Kishor5115/SkyForge-RISCV-SoC/docs/WAIVED_CHECKS.md

# SkyForge SoC — Signoff Waived Checks

Records all DRC/timing checks formally waived in the SkyForge v1.0 signoff
(`RUN_4_GDS_SIGNOFF`). All other checks are fully clean with zero violations.

## Final Signoff Metrics (RUN_4_GDS_SIGNOFF)

| Check | Result |
|---|---|
| `klayout__drc_error__count` | **0** |
| `design__lvs_error__count` | **0** |
| `design__lvs_device_difference__count` | **0** |
| `design__lvs_net_difference__count` | **0** |
| `route__drc_errors` | **0** |
| LVS verdict | **"Circuits match uniquely."** |
| STA (setup/hold @ 100 MHz TT) | WNS ≥ 0, TNS = 0, 0 hold violations |
| Antenna | 0 violations |

> **LVS is fully clean — not a waiver.** Netgen reports "Circuits match uniquely" with
> zero device/net/pin differences. There is exactly **one** formal waiver, described
> below (the OpenRAM SRAM internal DRC), which is standard hard-macro practice.

---

## Formal Waivers

### Waiver 1: OpenRAM SRAM Internal DRC (KLayout `sky130A` mr.drc)

**Scope:** Internal violations inside the pre-characterized OpenRAM SRAM macro GDS only.
All SoC routing, standard-cell fabric, and the macro integration boundary are fully
checked with **0 violations**.

**History:**
- Full-GDS KLayout run (initial): **2067 violations** — all `nsdm`/`nwell`/`psdm`
  (well/implant) rules inside the OpenRAM bitcell array.
- After `sky130A_mr_sram_waived.drc` (well/implant cell-scoped exclusion): **3 residual** —
  2× `m1.2` (met1 spacing) + 1× `m2.2` (met2 spacing) inside the
  `sky130_replica_bitcell_array` and `wmask_dff` subcells. Confirmed by running the same
  deck on the **standalone SRAM GDS** — identical 3 edge-pairs reproduced, proving these
  are inside the OpenRAM compiler output (≈10 nm spacing shorts: 0.13 vs 0.14 µm min),
  not in SoC routing or the integration boundary.
- After extending the `not_sram` cell scope to cover the `m1.2`/`m2.2` **spacing** rules
  (width rules still checked on the full layer): **0.**

**Engineering justification:**
Industry-standard hard-macro DRC practice. The SRAM is an unmodified OpenRAM compiler
output. Its internal violations are in the compiler-generated bitcell array, not in SoC
routing or the integration boundary. The macro is verified standalone; chip-level DRC
verifies only the integration boundary (placement, halo, routing to macro pins) — per
the OpenLane/LibreLane hardening guidance ("GDS DRC on macros, LEF/DEF DRC at the chip
level").

**Waiver implementation:** `librelane/sky130A_mr_sram_waived.drc` — a cell-scoped
exclusion (`SRAM_EXCLUDE` / `not_sram`) applied to `*sky130_sram_*kbyte_*` cells for the
well/implant rules **and** the `m1.2`/`m2.2` metal-spacing rules. Every rule still runs
on all non-SRAM geometry, including all SoC routing.

---

## Informational Notes (Not Waivers)

These are pre-signoff warnings from intermediate steps; none is a blocking signoff
failure, and each is resolved or benign in the final signed-off result.

### Note 1: OpenROAD PSM Power-Grid Violations (global routing)

**Observed:** `Grid check for vccd1 failed: PSM-0069`, 833 violations during global
routing (an *intermediate* step). **Status:** Informational — final Magic DRC = 0,
KLayout DRC = 0, LVS = 0.
**Justification:** PSM (power/IR integrity) requires `VSRC_LOC_FILES` (pad-ring source
locations) for accurate analysis; without a padframe it is pessimistic. Estimated IR
drop < 40 mV (< 2.8 % Vdd), within budget. Accurate PSM/IR signoff is a chip-integration
(padframe) step beyond this padless macro-level implementation.

### Note 2: Antenna Info Missing on `picorv32_axi` Macro Pins

**Observed:** `Cell 'picorv32_axi' has (1) input pin(s) without antenna gate
information` (plus 47 output pins without diffusion info). **Status:** Informational —
final antenna DRC = **0 violations**.
**Justification:** The hardened macro LEF lacks per-pin `ANTENNADIFFAREA`/
`ANTENNAGATEAREA` metadata (a LibreLane hierarchical-flow limitation). OpenROAD resolves
all antenna violations conservatively via diode insertion during detailed routing;
`route__drc_errors = 0`. Confirmed in `RUN_4_GDS_SIGNOFF`.

---

## Reference

- `librelane/sky130A_mr_sram_waived.drc` — the cell-scoped KLayout waiver deck.
- `librelane/docker_asic_flow.py` — the flow that produces `RUN_4_GDS_SIGNOFF`.
