Kishor5115/SkyForge-RISCV-SoC/tb/soc_top_tb.sv

`timescale 1ns / 1ps

module soc_top_tb;

    // -------------------------------------------------------------------------
    // Parameters & Signals
    // -------------------------------------------------------------------------
    parameter MEM_INIT_FILE = "sim/integration_test.hex";
    
    logic        clk;
    logic        rst_n;

    // UART
    logic        uart_tx;
    logic        uart_rx;

    // GPIO
    logic [31:0] gpio_in;
    logic [31:0] gpio_out;
    logic [31:0] gpio_oe;

    // SPI Master
    logic        spi_sclk;
    logic        spi_mosi;
    logic        spi_miso;
    logic [3:0]  spi_cs_n;

    // Flash QSPI
    logic        flash_sclk;
    logic        flash_cs_n;
    logic        flash_mosi;
    logic        flash_miso;

    // JTAG
    logic        jtag_tck;
    logic        jtag_tms;
    logic        jtag_tdi;
    logic        jtag_tdo;

    // Status
    logic        trap;

    // Testbench Control
    logic        start_jtag_test = 0;
    logic [31:0] idcode_val;
    logic [8*19-1:0] output_window = '0;
    logic        seen_uart_apb = 0;

    // -------------------------------------------------------------------------
    // Early diagnostics (no waveform needed)
    // -------------------------------------------------------------------------
    initial begin
        // Wait for reset to be released
        wait(rst_n == 1'b1);
        // Give the reset synchronizer a little time
        #200;

        // If firmware still hasn't touched UART, print some state to debug
        if (!seen_uart_apb) begin
            $display("[TB][DIAG] No UART APB traffic shortly after reset.");
            $display("[TB][DIAG] CPU dbg_pc = 0x%08X", dut.u_soc_core.dbg_cpu_pc);
            $display("[TB][DIAG] BootROM[0] = 0x%08X", dut.u_soc_core.u_bootrom.rom[0]);
        end
    end

    // -------------------------------------------------------------------------
    // Clock & Reset
    // -------------------------------------------------------------------------
    initial begin
        clk = 0;
        forever #5 clk = ~clk; // 100MHz clock
    end

    initial begin
        rst_n = 0;
        #50 rst_n = 1;
    end

    // -------------------------------------------------------------------------
    // SoC Instantiation
    // -------------------------------------------------------------------------
    soc_top #(
        .MEM_INIT_FILE(MEM_INIT_FILE),
        .BOOTROM_ADDR_WIDTH(13),
        .PROGADDR_IRQ(32'h00000010) // Run IRQ from BootROM for integration test
    ) dut (
        .clk        (clk),
        .rst_n      (rst_n),
        .uart_tx    (uart_tx),
        .uart_rx    (uart_rx),
        .gpio_in    (gpio_in),
        .gpio_out   (gpio_out),
        .gpio_oe    (gpio_oe),
        .spi_sclk   (spi_sclk),
        .spi_mosi   (spi_mosi),
        .spi_miso   (spi_miso),
        .spi_cs_n   (spi_cs_n),
        .flash_sclk (flash_sclk),
        .flash_cs_n (flash_cs_n),
        .flash_mosi (flash_mosi),
        .flash_miso (flash_miso),
        .jtag_tck   (jtag_tck),
        .jtag_tms   (jtag_tms),
        .jtag_tdi   (jtag_tdi),
        .jtag_tdo   (jtag_tdo),
        .trap       (trap)
    );

    // -------------------------------------------------------------------------
    // Hardware Loopbacks
    // -------------------------------------------------------------------------
    // GPIO Loopback
    assign gpio_in = gpio_out;

    // SPI Loopback
    assign spi_miso = spi_mosi;

    // Flash Loopback (Dummy response, just to keep it from hanging if it tries to read)
    assign flash_miso = 1'b1;

    // UART Loopback (Not used, we just monitor TX)
    assign uart_rx = 1'b1;

    // Removed buggy behavioral UART receiver. We print directly from APB writes below.

    // To make it 100% reliable, we peek at the UART TX register writes
    // internal to the DUT.
    always @(posedge clk) begin
        // One-time visibility: did firmware ever touch the UART?
        if (!seen_uart_apb && dut.u_soc_core.psel_uart && dut.u_soc_core.penable_uart) begin
            seen_uart_apb <= 1'b1;
            if (dut.u_soc_core.pwrite_uart) begin
                $display("[TB] First UART APB WRITE addr=0x%08X data=0x%08X", dut.u_soc_core.paddr_uart, dut.u_soc_core.pwdata_uart);
            end else begin
                $display("[TB] First UART APB READ  addr=0x%08X", dut.u_soc_core.paddr_uart);
            end
        end

        if (dut.u_soc_core.psel_uart && dut.u_soc_core.penable_uart && dut.u_soc_core.pwrite_uart) begin
            if (dut.u_soc_core.paddr_uart[7:0] == 8'h00) begin // UART_TX_DATA
                $write("%c", dut.u_soc_core.pwdata_uart[7:0]);
                $fflush();
                output_window = {output_window[8*18-1:0], dut.u_soc_core.pwdata_uart[7:0]};
                
                if (output_window[8*19-1:0] == "---FIRMWARE_PASS---") begin
                    $display("\n[TB] Detected FIRMWARE_PASS. Starting JTAG Test...");
                    start_jtag_test = 1;
                end
                if (output_window[8*15-1:0] == "---TEST_FAIL---") begin
                    $display("\n[TB] Detected TEST_FAIL from firmware.");
                    $fatal(1, "Integration Test Failed.");
                end
            end
        end
    end

    // If the CPU traps, fail fast (helps catch bad ROM images / bad mappings)
    always @(posedge clk) begin
        if (trap) begin
            $fatal(1, "[TB] CPU trap asserted.");
        end
    end

    // -------------------------------------------------------------------------
    // JTAG Master / Self-Test Sequence
    // -------------------------------------------------------------------------

    task jtag_reset;
        begin
            jtag_tck = 0; jtag_tms = 1; jtag_tdi = 0;
            // 5 clocks with TMS=1 ensures Test-Logic-Reset
            repeat(5) begin
                #50 jtag_tck = 1;
                #50 jtag_tck = 0;
            end
        end
    endtask

    task jtag_shift_ir(input logic [3:0] ir_val);
        begin
            // Move to Shift-IR
            // From TLR: 0(Run-Test-Idle) -> 1(Sel-DR) -> 1(Sel-IR) -> 0(Capture-IR) -> 0(Shift-IR)
            jtag_tms=0; #50 jtag_tck=1; #50 jtag_tck=0; // RTI
            jtag_tms=1; #50 jtag_tck=1; #50 jtag_tck=0; // Sel-DR
            jtag_tms=1; #50 jtag_tck=1; #50 jtag_tck=0; // Sel-IR
            jtag_tms=0; #50 jtag_tck=1; #50 jtag_tck=0; // Cap-IR
            jtag_tms=0; #50 jtag_tck=1; #50 jtag_tck=0; // Shift-IR
            
            // Shift 4 bits
            for(int i=0; i<4; i++) begin
                jtag_tdi = ir_val[i];
                if (i == 3) jtag_tms = 1; // Exit-1-IR on last bit
                else jtag_tms = 0;
                #50 jtag_tck=1; #50 jtag_tck=0;
            end
            
            // Update-IR -> Run-Test-Idle
            jtag_tms=1; #50 jtag_tck=1; #50 jtag_tck=0; // Update-IR
            jtag_tms=0; #50 jtag_tck=1; #50 jtag_tck=0; // RTI
        end
    endtask

    task jtag_shift_dr_32(input logic [31:0] dr_in, output logic [31:0] dr_out);
        begin
            // Move to Shift-DR
            // From RTI: 1(Sel-DR) -> 0(Cap-DR) -> 0(Shift-DR)
            jtag_tms=1; #50 jtag_tck=1; #50 jtag_tck=0; // Sel-DR
            jtag_tms=0; #50 jtag_tck=1; #50 jtag_tck=0; // Cap-DR
            jtag_tms=0; #50 jtag_tck=1; #50 jtag_tck=0; // Shift-DR
            
            dr_out = 0;
            for(int i=0; i<32; i++) begin
                jtag_tdi = dr_in[i];
                if (i == 31) jtag_tms = 1; // Exit-1-DR on last bit
                else jtag_tms = 0;
                
                #25;
                dr_out[i] = jtag_tdo; // Sample TDO before posedge
                #25 jtag_tck=1; #50 jtag_tck=0;
            end
            
            // Update-DR -> Run-Test-Idle
            jtag_tms=1; #50 jtag_tck=1; #50 jtag_tck=0; // Update-DR
            jtag_tms=0; #50 jtag_tck=1; #50 jtag_tck=0; // RTI
        end
    endtask

    initial begin
        jtag_tck = 0;
        jtag_tms = 1;
        jtag_tdi = 0;
        
        wait(start_jtag_test == 1);
        
        $display("[TB] Performing JTAG Test...");
        jtag_reset();
        
        // 1. Read IDCODE (IR = 0x1)
        jtag_shift_ir(4'h1);
        
        jtag_shift_dr_32(32'h0, idcode_val);
        $display("[TB] Read JTAG IDCODE: 0x%08X", idcode_val);
        if (idcode_val != 32'h10005001) begin
            $fatal(1, "JTAG IDCODE mismatch!");
        end
        
        $display("[TB] ---TEST_PASS---");
        $finish;
    end

    // -------------------------------------------------------------------------
    // Timeout
    // -------------------------------------------------------------------------
    initial begin
        #50000000; // 50ms timeout
        $display("\n[TB] Simulation Timeout!");
        $fatal(1, "Integration Test Failed.");
    end

endmodule
