Kishor5115/SkyForge-RISCV-SoC/(commit log)

2026-04-27 feat: UART added
2026-04-27 feat: timer and gpio added
2026-04-29 feat: SPI added along with firmware support
2026-05-03 feat: implement SoC infrastructure with new drivers, boot ROM, JTAG debug, and testbench suite
2026-05-30 feat: integrate FreeRTOS kernel, update SoC RTL, and refactor debug module logic
    [gdb_init.cfg]
2026-05-30 fix in the testbench and debug module
    [macro.cfg, pin_order.cfg]
2026-06-04 fix(asic): resolve SRAM STA blackbox, LVS, IR drop, and add implementation report
    - openram/build/*.lib: full timing arcs (clk→Q 2.6ns, setup 0.5ns, hold 0.25ns)
    from published sky130 SRAM characterization — unblocks STA
    - openram/generate_stub_gds.py: gdspy script to generate stub GDS in <10min,
    avoiding 4-8h full OpenRAM compile — unblocks LVS
    - openlane/config.json: add LVS_IGNORE_CELLS for SRAM, remove missing GDS ref,
    fix FP_CORE_UTIL to 45%, add MAGIC_EXT_USE_GDS flag
    - constraints/soc_core.sdc: add SRAM port delays, false paths, clock uncertainty,
    set_driving_cell/set_load, max_transition/fanout
    - flow/scripts/analyze_ir_drop.tcl: OpenROAD analyze_power_grid script for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
2026-06-09 feat(firmware): interactive FreeRTOS+CLI shell over UART
    Add an interactive command-line shell to the firmware using FreeRTOS+CLI,
    served over the SoC UART. Commands: help, ver, status, memread <addr>,
    gpio <hex>. The vTaskA/vTaskB blinkers keep running concurrently with the
    shell, demonstrating preemptive multitasking alongside interactive I/O.
    Firmware
    - cli/: FreeRTOS_CLI.c/.h (upstream, MIT) + cli_task.c + cli.h
    - main.c: uart_init(14) + cli_start() before the scheduler
    - FreeRTOSConfig.h: configCOMMAND_INT_MAX_OUTPUT_SIZE=256; heap 6KB->12KB
    - Makefile: build/include the CLI sources
    Memory
    - Scale SRAM 16KB -> 32KB (linker, sram_axi.sv, soc_core.sv, interconnect
    decode) to host the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
2026-06-09 fix the bug of keyboard polling
    [main.cpp]
2026-06-13 Update SRAM floorplan to 8 banks (32KB) in sky130 multi-macro flow
2026-06-13 Fix LibreLane v3 schema errors in soc_core_top.yaml
    [soc_core_top.yaml]
2026-06-13 Fix PicoRV32 parameter passing for hard macro compilation
    [picorv32_axi.sv, soc_core.sv]
2026-06-13 Lower placement density to fix DRT pin access failures
2026-06-13 Fix DRT-0073: use li1 as min routing layer for sky130 cell pin access
2026-06-15 Fix and suppress Verilator lint warnings for clean flow
    - picorv32.sv: add lint_off BLKSEQ, UNUSEDSIGNAL, GENUNNAMED, TIMESCALEMOD
    - Name all 7 anonymous generate blocks (gen_fast_mul, gen_mul, gen_no_mul,
    gen_div, gen_no_div, gen_two_cycle_alu, gen_comb_alu) — fixes GENUNNAMED
    - picorv32_pcpi.sv: add lint_off WIDTHEXPAND, WIDTHTRUNC, UNUSEDSIGNAL, CASEINCOMPLETE
    - Add default: ; to MUL and DIV case statements — fixes CASEINCOMPLETE
    - picorv32_axi.sv: add lint_off UNUSEDSIGNAL
    Zero logic changes; all RTL behaviour is 100% identical.
    [picorv32.sv, picorv32_axi.sv, picorv32_pcpi.sv]
2026-06-15 Fix DRT-0073, STA-0441; expand SRAM to 8 banks (32 KB)
    picorv32_core.yaml (rewritten from canonical picorv32a reference):
    - ROOT CAUSE: CTS_APPLY_NDR=half applied 2X clock-net spacing that
    blocked detailed router access to clkbuf A-pins → DRT-0073
    - FIX: CTS_APPLY_NDR: none (verified: 0 DRT-0073, clean GDS/LEF)
    - FP_CORE_UTIL 35, PL_TARGET_DENSITY_PCT 50, SYNTH_STRATEGY AREA 0
    - Default sky130A routing (met1..met5), no layer hacks needed
    soc_core.sdc:
    - Replace remove_from_collection (Synopsys-only) with OpenSTA-safe
    lsearch/lreplace to exclude clk port from set_input_delay (STA-0441)
    soc_core_top.yaml:
    - DIE_AREA expanded 2200x2600 → 2200x3300 for 8 SRAM banks
    docker_asic_flow.py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
    [soc_core_top.yaml]
2026-06-15 Add LINTER_DISABLE_WARNINGS_BLACKBOX to suppress PDK TIMESCALEMOD
    PDK blackbox stubs (sky130_fd_sc_hd cells) lack a timescale directive,
    triggering TIMESCALEMOD warnings against user RTL that has one. This is
    cosmetic and doesn't block the flow, but clutters the lint output.
2026-06-15 soc_core_top: add linter blackbox suppression, CTS_APPLY_NDR, RUN_TAG_TOP
    - LINTER_DISABLE_WARNINGS_BLACKBOX: suppress TIMESCALEMOD from PDK stubs
    - CTS_APPLY_NDR: none (same DRT-0073 prevention as core macro)
    soc_asic_flow.ipynb:
    - Added RUN_TAG_TOP parameter in config cell
    - Step 5 (chip-top) command uses --run-tag {RUN_TAG_TOP}
    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
    [soc_core_top.yaml]
2026-06-15 Suppress PINMISSING (142k PDK warnings) and MODDUP (SRAM duplicate)
    - LINTER_DISABLE_WARNINGS_BLACKBOX += PINMISSING (sky130 std cell blackboxes
    have power pins not connected in behavioral models → 142k warnings)
    - LINTER_DISABLE_WARNINGS += MODDUP (SRAM module defined in both user RTL
    and LibreLane-generated blackbox stub)
    picorv32_core.yaml:
    - LINTER_DISABLE_WARNINGS_BLACKBOX += PINMISSING (consistency)
    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
2026-06-15 soc_core_top: add missing axi_interconnect.sv, suppress lint errors
    - Added dir::../rtl/interconnect/axi_interconnect.sv to VERILOG_FILES
    (instantiated by axi_interconnect_2m.sv but was missing from file list)
    - LINTER_DISABLE_WARNINGS += MODMISSING (picorv32_axi is a hardened macro
    provided via MACROS block at P&R time, not available during lint)
    - LINTER_DISABLE_WARNINGS += PINCONNECTEMPTY (intentional unconnected pins
    in gpio_apb.sv and uart_ctrl_apb.sv)
    [soc_core_top.yaml]
2026-06-15 soc_core_top: fix synth check errors (blackbox macros) + add missing RTL
    - ERROR_ON_SYNTH_CHECKS: false — Yosys counts blackbox macro instances
    (1x picorv32_axi + 8x SRAM = 9) as 'check errors'; these are valid
    hardened macros, not real problems (CHECK pass reports 0 problems)
    - Added axi_interconnect.sv to VERILOG_FILES (prior commit)
    [soc_core_top.yaml]
2026-06-16 soc_core_top: fix all Step 5 errors found during run
    - STA_CORNERS: 1 corner (nom_tt) to prevent OOM during RCX/STA (was 9)
    - EXTRA_VERILOG_MODELS: picorv32_axi.nl.v so Yosys finds the hardened macro
    - ERROR_ON_SYNTH_CHECKS: false (9 blackbox macros trigger false Yosys errors)
    - IGNORE_DISCONNECTED_MODULES: sky130_sram (blackboxed, not real disconnects)
    - Added axi_interconnect.sv to VERILOG_FILES (was missing, caused MODMISSING)
    - LINTER_DISABLE_WARNINGS += MODMISSING, PINCONNECTEMPTY
    - CTS_APPLY_NDR: none (same DRT-0073 fix as core macro)
    docker_asic_flow.py:
    - Instance name u_core → u_cpu (matches RTL: soc_core.sv uses u_cpu)
    - PDN_MACRO_CONNECTIONS regex updated: .*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
    [soc_core_top.yaml]
2026-06-16 openram: fix SRAM LEF DATABASE MICRONS 2000→1000 for sky130A
    sky130A tech uses 1000 DBU/um; OpenRAM generated the LEF with 2000.
    OpenROAD discards the LEF with ODB-0292 if the unit factor exceeds
    the technology database units per micron.
2026-06-19 Add sky130_fd_io padring wrapper (reference artifact)
    Pin-to-edge assignment matches 2400x2000 area-optimised floorplan:
    - EAST : CLK, RST, UART, JTAG, SPI, GPIO[15:0]
    - WEST : FLASH QSPI, GPIO[31:16]
    - SOUTH: TRAP only (South edge mostly blocked by rotated SRAMs)
    - NORTH: No signal pads (SRAM[6,7] block top edge)
2026-06-22 feat(v2): execute FreeRTOS from external flash via cached XIP; 16KB SRAM
    RTL:
    - sram_axi: ADDR_WIDTH 15->14 (32KB/8 banks -> 16KB/4 banks)
    - soc_core: 16KB SRAM wiring; flash_ctrl replaced by flash_xip wrapper;
    PROGADDR_IRQ -> 0x40010010 (flash XIP IRQ vector)
    - axi_interconnect: SRAM decode bound 0x18000 -> 0x14000
    - icache_1k: new 1KB direct-mapped read cache (32 lines x 8 words, FF-based)
    fronting the flash XIP read port
    - flash_xip: new wrapper owning S2 flash region; splits register window
    (0x40000000-0x4000FFFF) from cached XIP window (0x40010000-0x40FFFFFF);
    wires the previously tied-off flash_ctrl XIP read port through the I-Cache
    - flash_ctrl: fix XIP read word assembly to l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
    [axi_interconnect.sv, boot_rom.c, flash_ctrl.sv, flash_model.sv, flash_xip.sv, flash_xip_tb.sv, icache_1k.sv, soc_core.sv]
2026-06-26 feat: soc v2 with 16KB ram
    [soc_core_pins.cfg, soc_padring_pins.cfg]
2026-07-09 feat(v2): professionalize flash-XIP branch — 8KB SRAM, drop padring, pre-DRT flow
    - Rename *_v2 flow files to regular names (docker_asic_flow.py,
    generate_notebook.py, soc_asic_flow.ipynb); fix internal refs.
    - On-chip SRAM 16KB->8KB: sram_axi ADDR_WIDTH 14->13 (auto 4->2 banks),
    soc_core u_sram slices [12:0], axi_interconnect SRAM region 0x10000-0x11FFF,
    firmware linker SRAM 8K + FreeRTOS heap 12K->5K (fits 8K: data+bss=5.7K).
    - Flow: 2 native-N banks (no rotation), die 1800x1400, macro_n-only PDN;
    chip-top stops at OpenROAD.GlobalRouting (before detailed routing);
    RUN flags set for core-first workflow; GDS/signoff stages gated off.
    - Remove padring entirely: soc_padring_top.yam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
    [soc_padring_pins.cfg]
2026-07-09 fix(v2): port SPI yosys-checker fix + 33-bit SRAM Liberty from librelane
    - spi_master_apb.sv: replace dynamic bit-select shift_in[out_bit_idx]<=miso with
    a combinational shift_in_next mux tree (ported from librelane) -> eliminates
    the 10 Yosys 'wire used but has no driver' checker warnings.
    - openram/build SRAM .lib: use the corrected 33-bit Liberty (bus_data bit_width
    33, din0/dout0[32:0]) matching the spare-column LEF/.v/netlist -> eliminates
    ORD-2001 'pin din0[32] missing' + STA-0200 'port size 32 != net size 33'.
    - docker_asic_flow.py: run flags set for the SoC top run (stage/harden off,
    patch+chip-top on) to global routing.
    Verified in RUN_GR1: lint clean, 0 yosys check warnin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
    [spi_master_apb.sv]
2026-07-12 feat: optimize 100MHz ASIC flow with macro power fixes, cache reduction, and added documentation for STA and top-level warnings.
    [flash_xip.sv, soc_core_top.yaml]
2026-07-13 feat: SkyForge v1.0 — full signoff complete (DRC/LVS/STA all clean)
    Production run RUN_4_GDS_SIGNOFF confirms:
    - Magic DRC: 0 violations (sky130A abstract DRC)
    - KLayout DRC: 0 violations (sky130A mr.drc + cell-scoped SRAM waiver deck)
    - LVS: 0 errors — Circuits match uniquely (Netgen, fully clean)
    - STA: closed at 100 MHz TT/1.8V/25C (WNS>=0, hold clean)
    - Routing DRC: 0 errors
    - Antenna: 0 violations
    Also in this commit:
    - README completely rewritten for open-source audience (Docker-first)
    - instructions/ folder added with Docker setup guides (Linux & Windows)
    - docs/WAIVED_CHECKS.md — KLayout SRAM cell-scoped waiver documented
    - CHANGELOG.md updated to v1.0.0
    - THIRD_PARTY_NOTICES.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
    [macro.cfg, pin_order.cfg]
